hanrrysantos/trabalho_robotica_movel/modelos_3d/README.md

# Modelos 3D para impressão

Esta pasta contém as modelagens oficiais do chassi e da estrutura do robô, em formato STL binário.

| Arquivo | Peça | Revisão |
|---|---|---:|
| `01_Base_Rev18.stl` | Base do robô | 18 |
| `02_Plataforma_Superior_Rev22.stl` | Plataforma superior | 22 |
| `07_Frente_Portal_Rev42.stl` | Frente/portal | 42 |
| `08_Traseira_Rev42.stl` | Parte traseira | 42 |
| `09_Tampa_Superior_Rev42.stl` | Tampa superior | 42 |
| `10_Cabeca_Casco_Pescoco_Rev48.stl` | Casco e pescoço da cabeça | 48 |
| `11_Cabeca_Tampa_Traseira_Rev48.stl` | Tampa traseira da cabeça | 48 |
| `12_Cabeca_Base_Servo_Rev48.stl` | Base do servo da cabeça | 48 |
| `Paredes_e_Bracos_Rev34_Impressao_Unica.stl` | Paredes e braços numa única mesa | 34 |

## Como usar

1. Importe os arquivos necessários no fatiador da impressora 3D.
2. Confira escala, orientação, encaixes e dimensões antes de iniciar a impressão.
3. Defina altura de camada, preenchimento, suportes, material e temperaturas conforme a impressora e o filamento utilizados.

O pacote recebido não inclui parâmetros de fatiamento. Por isso, o repositório não define um perfil universal de impressão. Os números de revisão fazem parte dos nomes dos arquivos e devem ser preservados ao distribuir ou substituir uma peça.
