hanrrysantos/trabalho_robotica_movel/modelos_3d/Paredes_e_Bracos_Rev34_Impressao_Unica.stl

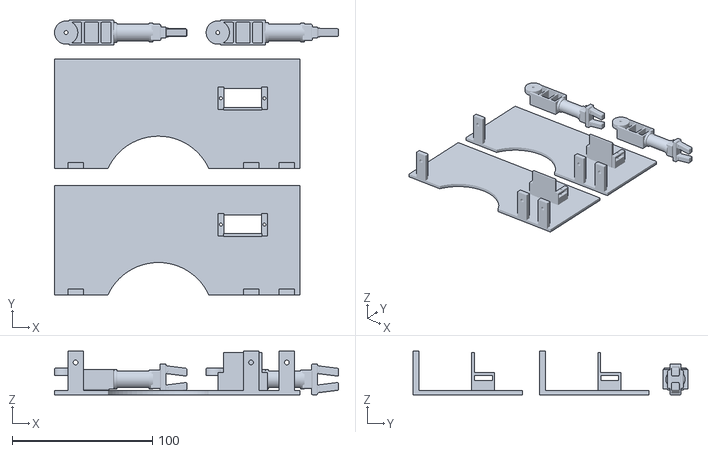
[picture p1: CAD file, 2026-11-10]
modelos_3d/Paredes_e_Bracos_Rev34_Impressao_Unica.stl
202.3 x 196.0 x 31.0
