hanrrysantos/trabalho_robotica_movel/modelos_3d/10_Cabeca_Casco_Pescoco_Rev48.stl

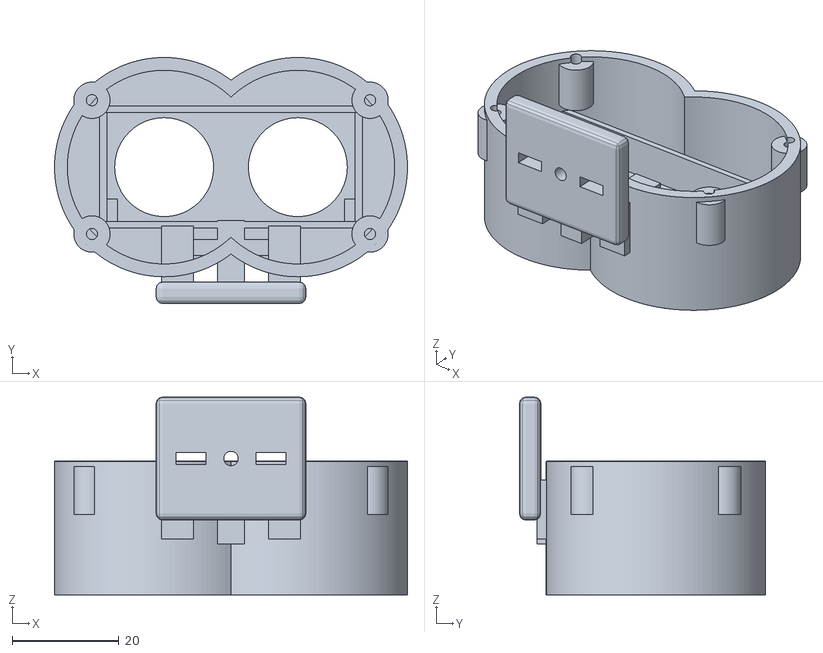
[picture p2: CAD file, 2026-11-10]
modelos_3d/10_Cabeca_Casco_Pescoco_Rev48.stl
66.0 x 46.0 x 37.0
