hanrrysantos/trabalho_robotica_movel/modelos_3d/07_Frente_Portal_Rev42.stl

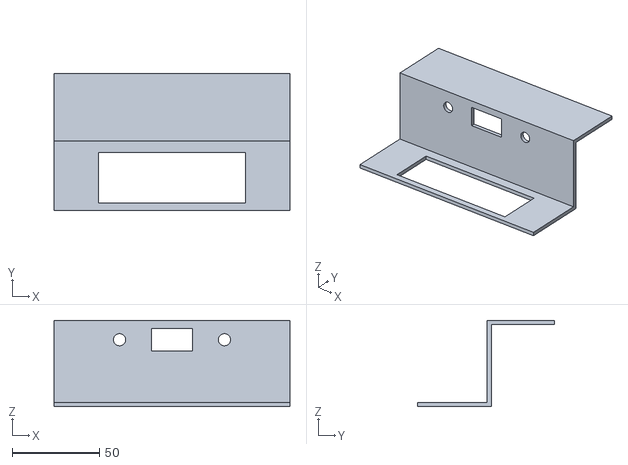
[picture p3: CAD file, 2026-11-10]
modelos_3d/07_Frente_Portal_Rev42.stl
135.0 x 78.2 x 49.2
