hanrrysantos/trabalho_robotica_movel/modelos_3d/08_Traseira_Rev42.stl

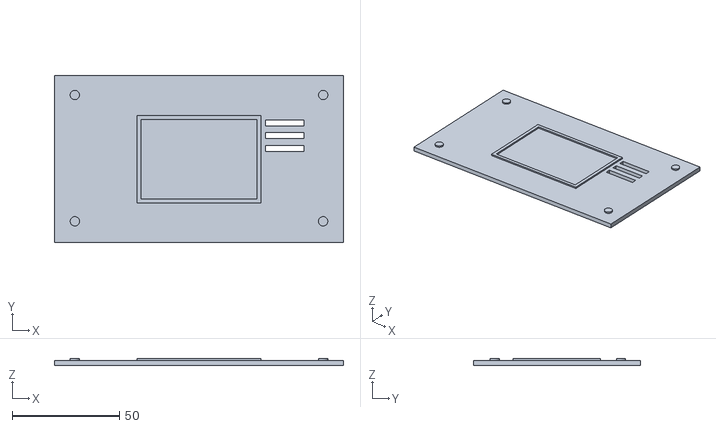
[picture p4: CAD file, 2026-11-10]
modelos_3d/08_Traseira_Rev42.stl
135.0 x 78.2 x 3.20
