hanrrysantos/trabalho_robotica_movel/modelos_3d/09_Tampa_Superior_Rev42.stl

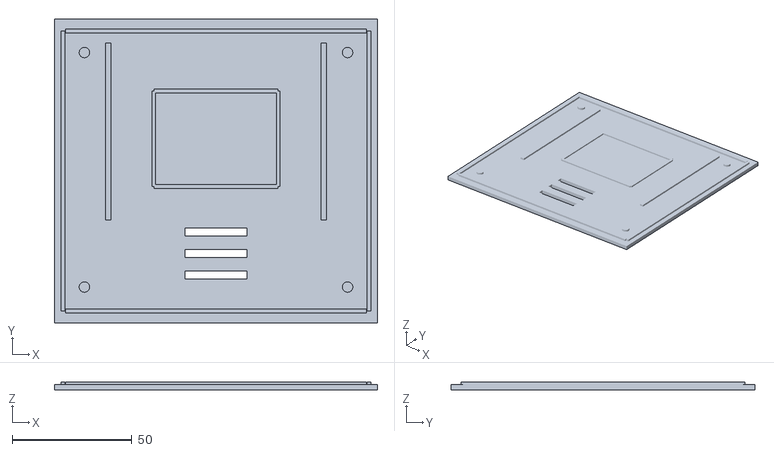
[picture p5: CAD file, 2026-11-10]
modelos_3d/09_Tampa_Superior_Rev42.stl
135.0 x 127.0 x 3.55
