hanrrysantos/trabalho_robotica_movel/modelos_3d/01_Base_Rev18.stl

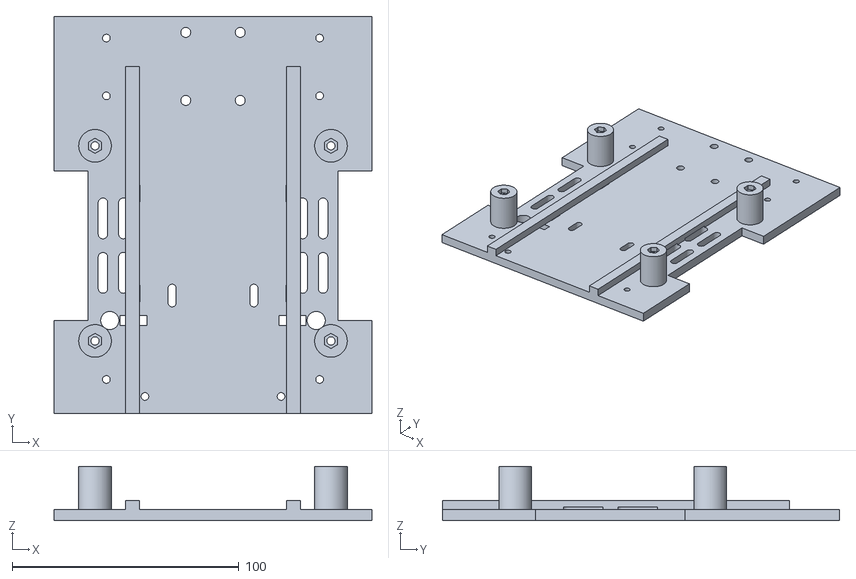
[picture p6: CAD file, 2026-11-10]
modelos_3d/01_Base_Rev18.stl
140.0 x 175.0 x 24.0
