hanrrysantos/trabalho_robotica_movel/modelos_3d/12_Cabeca_Base_Servo_Rev48.stl

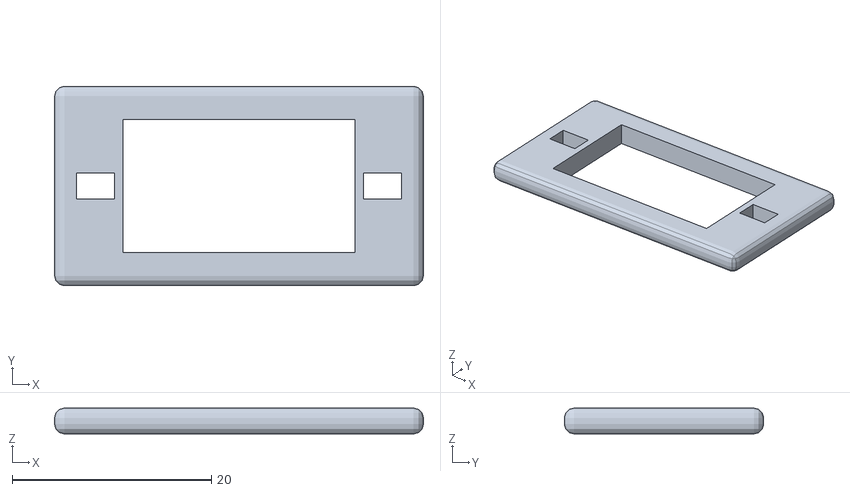
[picture p7: CAD file, 2026-11-10]
modelos_3d/12_Cabeca_Base_Servo_Rev48.stl
37.0 x 20.0 x 2.60
