hanrrysantos/trabalho_robotica_movel/modelos_3d/02_Plataforma_Superior_Rev22.stl

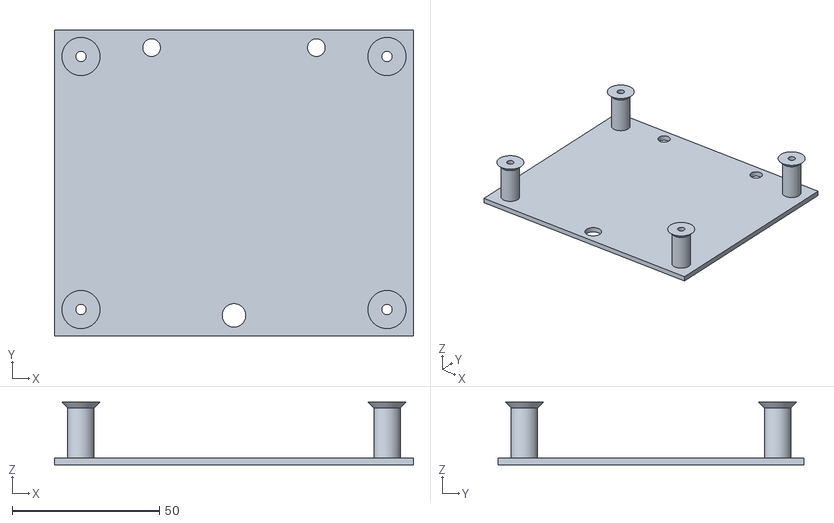
[picture p8: CAD file, 2026-11-10]
modelos_3d/02_Plataforma_Superior_Rev22.stl
122.0 x 104.0 x 21.4
