hanrrysantos/trabalho_robotica_movel/modelos_3d/11_Cabeca_Tampa_Traseira_Rev48.stl

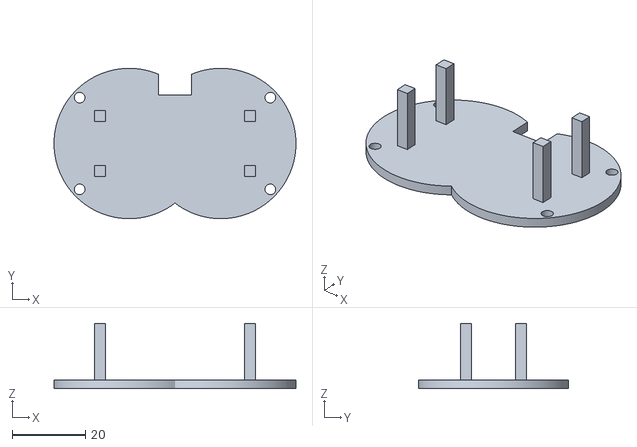
[picture p9: CAD file, 2026-11-10]
modelos_3d/11_Cabeca_Tampa_Traseira_Rev48.stl
66.0 x 41.0 x 17.8
